ROCO504/2016-group4/Renders/Complete_Arm_2016-Dec-10_07-11-23PM-000_CustomizedView5352551910.png

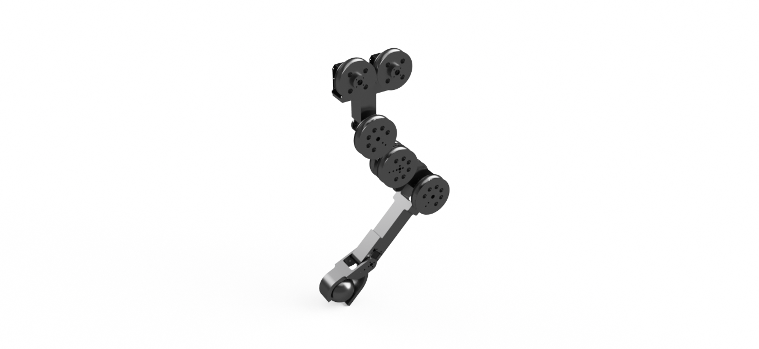
Renders/Complete_Arm_2016-Dec-10_07-11-23PM-000_CustomizedView5352551910.png
