ROCO504/2016-group4/Renders/Complete_Arm_2016-Dec-10_07-11-47PM-000_CustomizedView19155642644.png

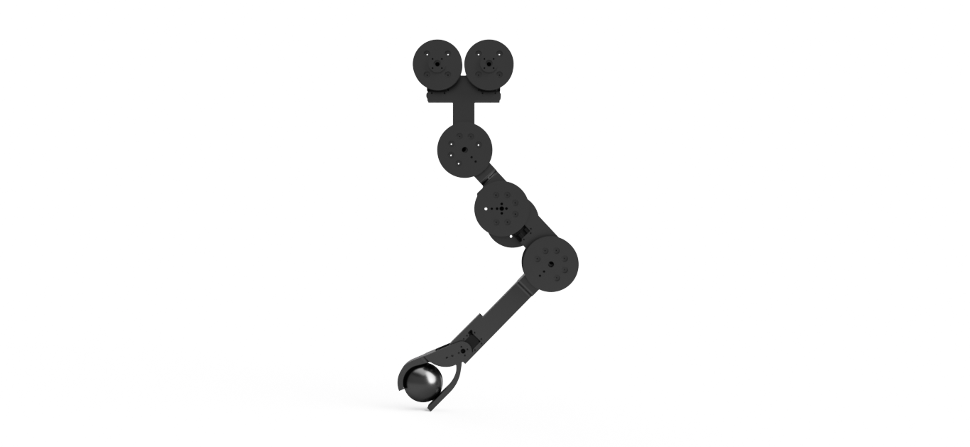
Renders/Complete_Arm_2016-Dec-10_07-11-47PM-000_CustomizedView19155642644.png
