ROCO504/2016-group4/(list of files, cad)

Other CAD files:
Throw Data/throw_2.stp
Throw Data/throw_1.stp
