ROCO504/2016-group4/(commit log)

2017-01-11 Added the arm software vi
    this vi was previously called Arm Calibration JOSH waitcase
2017-01-11 CAD model added
    added .iges file (made in fusion 360) of entire arm. top spools are
    currently the wrong way round
2017-01-11 Renders Added
    two 3d renders of the arm added
2017-01-11 Throw Data Added
    [throw_1.stp, throw_2.stp]
2017-01-11 Throw data moved to folder
    [throw_1.stp, throw_2.stp]
